hpy666666/xiaozhi-esp32-pet/docs/pet/照片添加指南.md

# 📸 照片添加指南

## 需要拍摄的照片

请将照片拍好后放到项目的 `docs/pet/` 目录中，并按以下命名：

### 1️⃣ 整体外观 (1张)
- **cover.jpg** - 项目封面，展示完整的宠物机器人
  - 建议角度：45度斜角，能看到屏幕和舵机
  - 建议背景：纯色或简洁背景
  - 建议光线：充足自然光

### 2️⃣ 硬件细节 (3张)
- **hardware-front.jpg** - 正面视角
  - 展示OLED屏幕、麦克风、扬声器位置

- **hardware-back.jpg** - 背面接线
  - 展示舵机连接、电源模块、PCB布局

- **pcb-detail.jpg** - PCB细节
  - 展示主控芯片、电源模块、接口等

### 3️⃣ 表情演示 (3张)
- **emotion-idle.jpg** - 待机状态
  - 屏幕显示慵懒眨眼动画

- **emotion-happy.jpg** - 开心表情
  - 屏幕显示开心表情（圆眼睛）

- **emotion-speaking.jpg** - 说话中
  - 屏幕显示说话表情（张嘴）

### 4️⃣ 动作演示 (3张)
- **action-stand.jpg** - 站立姿态
  - 4个舵机处于站立位置（90度）

- **action-sit.jpg** - 坐下
  - 前腿趴下，后腿站立

- **action-wave.jpg** - 挥手
  - 右前腿抬起摆动

---

## 📷 拍摄技巧

### 照片要求
- **分辨率**: 至少 1280×720 (720p)
- **格式**: JPG 或 PNG
- **大小**: 单张不超过 2MB（GitHub会自动压缩）
- **方向**: 横向拍摄（16:9 或 4:3）

### 光线建议
- ✅ 使用自然光或白色LED灯
- ✅ 避免强烈阴影
- ❌ 避免逆光（屏幕会看不清）
- ❌ 避免黄光（颜色失真）

### 背景建议
- ✅ 纯色背景（白色、浅灰、浅蓝）
- ✅ 简洁的桌面
- ❌ 杂乱的环境
- ❌ 太花哨的背景

### 拍摄角度
- **整体照**: 45度斜角，能看到正面和侧面
- **细节照**: 正面或侧面，焦点清晰
- **屏幕照**: 正对屏幕，略微俯拍，避免反光

---

## 📁 如何添加照片到项目

### 方法1：复制到项目目录（推荐）

1. 将拍好的照片重命名（按上面的命名规则）
2. 复制到项目目录：
   ```
   C:\Users\34376\Desktop\xiaozhi-esp32-1.9.2_2\xiaozhi-esp32-1.9.2_2\docs\pet\
   ```
3. 使用Git提交：
   ```bash
   cd "C:\Users\34376\Desktop\xiaozhi-esp32-1.9.2_2\xiaozhi-esp32-1.9.2_2"
   git add docs/pet/*.jpg
   git commit -m "docs: 添加项目展示图片"
   git push
   ```

### 方法2：通过GitHub网页上传

1. 访问：https://github.com/hpy666666/xiaozhi-esp32-pet/tree/main/docs
2. 点击 "Add file" → "Upload files"
3. 创建 `pet/` 文件夹并上传照片
4. 填写commit信息："docs: 添加项目展示图片"
5. 点击 "Commit changes"

---

## ✅ 上传完成后

README中的图片会自动显示：
- https://github.com/hpy666666/xiaozhi-esp32-pet#-项目展示

如果照片数量不够，可以先上传部分，其余的后续补充。

---

## 📝 可选照片

如果想让项目更丰富，还可以添加：

- **wiring-diagram.jpg** - 接线图示意
- **size-comparison.jpg** - 与参照物对比大小
- **assembly-process.jpg** - 组装过程照片
- **gif-animation.gif** - 眨眼动画的GIF截图
- **action-sequence.gif** - 动作序列GIF

---

**准备好照片后告诉我，我可以帮你优化README的展示效果！**
