hpy666666/xiaozhi-esp32-pet/docs/guides/IDLE_ANIMATION_IMPLEMENTATION_SUMMARY.md

# Idle 眨眼动画系统实施完成总结

## ✅ 已完成的工作

### 1. 核心文件创建

#### 新增文件（6个）：
- ✅ `main/display/blink_animator.h` - 眨眼动画播放器接口
- ✅ `main/display/blink_animator.c` - 眨眼动画播放器实现
- ✅ `main/display/idle_emotion_controller.h` - Idle 状态控制器接口
- ✅ `main/display/idle_emotion_controller.c` - Idle 状态控制器实现
- ✅ `IDLE_BITMAPS_DESIGN.md` - 位图设计文档
- ✅ `IDLE_ANIMATION_IMPLEMENTATION_SUMMARY.md` - 本文档

### 2. 修改文件

#### `main/display/emotion_bitmaps.h`
- 新增 9 个枚举（3个系列 × 3个状态）
- EMOTION_COUNT 更新为 17

#### `main/display/emotion_bitmaps.c`
- 新增 9 个位图数据条目
- ⚠️ 当前使用占位符（复用现有位图）
- 📝 TODO: 替换为真实设计的位图

#### `main/display/oled_display.h`
- 新增 `IdleEmotionController idle_controller_` 成员
- 新增 `StartIdleAnimation()` / `StopIdleAnimation()` 方法

#### `main/display/oled_display.cc`
- 构造函数中初始化 `idle_controller_`
- 析构函数中清理 `idle_controller_`
- 实现 `StartIdleAnimation()` 和 `StopIdleAnimation()`

#### `main/application.cc`
- 修改 `SetDeviceState()` 添加 idle 动画控制逻辑
- kDeviceStateIdle → 启动 idle 动画
- 其他状态 → 停止 idle 动画，显示静态表情

#### `main/CMakeLists.txt`
- 添加 `blink_animator.c`
- 添加 `idle_emotion_controller.c`

---

## 🎯 系统功能

### 功能概述

**Idle 状态下**：
1. 每 5 分钟自动循环切换表情：
   - 0-5分钟: Normal 表情
   - 5-10分钟: Sleepy 表情
   - 10-15分钟: Bored 表情
   - 15分钟后循环回 Normal

2. 每个表情有独立的眨眼频率：
   - Normal: 3-5秒随机眨一次
   - Sleepy: 4-6秒随机眨一次（更慵懒）
   - Bored: 5-7秒随机眨一次（最慢）

3. 眨眼动画：
   - 5帧序列：睁眼 → 半闭 → 闭眼 → 半闭 → 睁眼
   - 每帧 80ms，总时长 400ms

**非 Idle 状态**：
- 停止眨眼动画
- 显示对应的静态表情（基于 emotion_manager.c 的映射）

---

## 📊 技术架构

```
Application (application.cc)
    ↓
SetDeviceState(kDeviceStateIdle)
    ↓
OledDisplay::StartIdleAnimation()
    ↓
IdleEmotionController
    ├─ State Switch Timer (5分钟)
    │   └─ Normal → Sleepy → Bored → 循环
    ├─ Blink Timer (3-7秒随机)
    │   └─ 触发 BlinkAnimator
    └─ BlinkAnimator
        └─ Frame Timer (80ms)
            └─ 播放5帧眨眼序列
```

---

## ⚠️ 注意事项

### 1. 位图占位符

**当前状态**: 9 个新表情使用占位符数据（复用现有位图）

**位置**: `main/display/emotion_bitmaps.c` 行 613-680

```c
// 临时占位符示例
[EMOJI_IDLE_NORMAL_OPEN] = {
    .data = emoji_happy_data,  // ← 复用现有位图
    ...
},
```

**替换方法**:
1. 参考 `IDLE_BITMAPS_DESIGN.md` 中的参数
2. 使用绘图软件（Paint.NET, GIMP等）绘制 9 个 128x64 位图
3. 用 image2cpp 转换（https://javl.github.io/image2cpp/）
4. 替换占位符数据

### 2. 测试时可缩短时间

**位置**: `main/display/idle_emotion_controller.c` 行 13

```c
#define STATE_SWITCH_INTERVAL_MS (5 * 60 * 1000)  // 5 minutes
```

**测试建议**: 改为 30 秒便于快速验证
```c
#define STATE_SWITCH_INTERVAL_MS (30 * 1000)  // 30 seconds for testing
```

### 3. 线程安全

所有 LVGL 操作都通过 `DisplayLockGuard` 保护，无需担心多线程问题。

---

## 🚀 编译和测试步骤

### 步骤 1: 进入项目目录

```bash
cd C:\Users\34376\Desktop\xiaozhi-esp32-1.9.2_2\xiaozhi-esp32-1.9.2_2
```

### 步骤 2: 删除旧的编译文件

```bash
idf.py fullclean
```

### 步骤 3: 重新编译项目

```bash
idf.py build
```

### 步骤 4: 烧录到设备并监视串口

```bash
idf.py -p COM5 flash monitor
```
（根据实际串口号调整 COM5）

---

## 💾 内存占用分析

### Flash 存储占用

**位图数据**:
- 原有 8 个表情: 8 × 1024 = 8,192 字节 (8 KB)
- 新增 9 个表情: 9 × 1024 = 9,216 字节 (9 KB)
- **总计**: 17,408 字节 (**17 KB**)
- 📝 注意：当前占位符阶段实际新增很少，真实位图替换后才会占用 9 KB

**代码占用**:
- blink_animator.c: ~3 KB
- idle_emotion_controller.c: ~5 KB
- 其他修改: ~2 KB
- **总计**: ~10 KB

**Flash 总新增**:
- 占位符阶段: ~10 KB
- 真实位图替换后: ~20 KB

### RAM 运行时占用

- IdleEmotionController 结构体: < 200 字节
- BlinkAnimator 结构体: < 100 字节
- ESP 定时器 (3个): ~150 字节
- **总计**: < **500 字节**

### 结论

✅ ESP32-S3 拥有 **8MB PSRAM** 和 **16MB Flash**
✅ 本系统仅占用 **20 KB Flash** + **500 字节 RAM**
✅ **完全无需担心内存问题**

---

## 👀 测试验证

### 观察串口日志

关键日志信息：

```
I (xxx) OledDisplay: Idle emotion controller initialized
I (xxx) IdleController: Starting idle animation
I (xxx) IdleController: State 0 (Normal)
I (xxx) IdleController: Next blink in 3245 ms
I (xxx) BlinkAnimator: Starting blink animation (open=8, half=9, closed=10)
I (xxx) IdleController: Switched to state 1 (Sleepy)
I (xxx) IdleController: Switched to state 2 (Bored)
```

### 步骤 4: 验证功能

**预期行为**:

1. **进入 Idle 状态**:
   - 屏幕显示表情（当前为占位符位图）
   - 每 3-5 秒眨眼一次

2. **切换到其他状态（如 Listening）**:
   - 眨眼停止
   - 显示 Listening 对应的静态表情

3. **回到 Idle**:
   - 重新开始眨眼动画
   - 从 Normal 状态开始

4. **长时间待机（测试完整循环）**:
   - 0-5min: Normal 眨眼
   - 5-10min: Sleepy 眨眼（更慢）
   - 10-15min: Bored 眨眼（最慢）
   - 15min后: 循环回 Normal

---

## 🐛 可能的编译错误

### 错误 1: 找不到 idle_emotion_controller.h

**原因**: CMakeLists.txt 未更新

**解决**: 确认 CMakeLists.txt 包含：
```cmake
"display/blink_animator.c"
"display/idle_emotion_controller.c"
```

### 错误 2: 未定义的引用

**可能原因**: C/C++ 链接问题

**解决**: 检查 `extern "C"` 声明是否正确

### 错误 3: EMOTION_COUNT 不匹配

**原因**: emotion_bitmaps.h 中 EMOTION_COUNT 应为 17

**解决**: 确认枚举定义正确

---

## 📝 后续工作

### 必做（影响功能）:

1. **替换占位符位图**
   - 使用 IDLE_BITMAPS_DESIGN.md 中的参数
   - 绘制真实的眨眼序列位图
   - 优先级: ★★★★★

### 可选（优化体验）:

2. **调整眨眼频率**
   - 根据实际观感微调 3-7 秒的范围
   - 优先级: ★★★☆☆

3. **添加更多 Idle 表情**
   - 例如: Curious, Playful, Relaxed
   - 修改 `idle_emotion_controller.c` 添加到循环
   - 优先级: ★★☆☆☆

4. **实现动态眼球追踪**
   - 参考 dog 项目的 LookAssistant
   - 眼球可以在 idle 时看向不同方向
   - 优先级: ★★★★☆

---

## 📚 相关文件索引

| 文件 | 用途 | 关键函数 |
|---|---|---|
| `blink_animator.c` | 眨眼动画播放 | `blink_animator_play()` |
| `idle_emotion_controller.c` | Idle 状态管理 | `idle_controller_start/stop()` |
| `oled_display.cc` | 集成点 | `StartIdleAnimation()` |
| `application.cc` | 状态机触发 | `SetDeviceState()` |
| `emotion_bitmaps.c` | 位图数据 | 占位符位置 613-680 行 |
| `IDLE_BITMAPS_DESIGN.md` | 设计文档 | 位图绘制参数 |

---

## ✨ 成果

通过本次实施，你的小智宠物现在拥有：

✅ **生动的 Idle 状态** - 不再是死板的静态画面
✅ **自动眨眼** - 显得更"活着"
✅ **状态变化** - 5 分钟循环展现不同"心情"
✅ **智能切换** - Idle 和工作状态无缝过渡
✅ **可扩展架构** - 未来可轻松添加更多表情或动画

---

**实施日期**: 2025-11-08
**版本**: xiaozhi-esp32 v1.9.2+
**状态**: ✅ 代码完成，等待编译测试
