hpy666666/xiaozhi-esp32-pet/(list of files, drawings)

Other design files:
hardware/ProDoc_PCB2_2026-01-19.epro
hardware/ProDoc_Schematic1_2026-01-19.epro
