hpy666666/xiaozhi-esp32-pet/main/display/lazy_blink_gif.c

#ifdef __has_include
    #if __has_include("lvgl.h")
        #ifndef LV_LVGL_H_INCLUDE_SIMPLE
            #define LV_LVGL_H_INCLUDE_SIMPLE
        #endif
    #endif
#endif

#if defined(LV_LVGL_H_INCLUDE_SIMPLE)
    #include "lvgl.h"
#else
    #include "lvgl/lvgl.h"
#endif


#ifndef LV_ATTRIBUTE_MEM_ALIGN
#define LV_ATTRIBUTE_MEM_ALIGN
#endif

#ifndef LV_ATTRIBUTE_IMG_LAZY_BLINK_GIF
#define LV_ATTRIBUTE_IMG_LAZY_BLINK_GIF
#endif

const LV_ATTRIBUTE_MEM_ALIGN LV_ATTRIBUTE_LARGE_CONST LV_ATTRIBUTE_IMG_LAZY_BLINK_GIF uint8_t lazy_blink_gif_map[] = {
    0x47, 0x49, 0x46, 0x38, 0x39, 0x61, 0x80, 0x00, 0x40, 0x00, 0xf4, 0x0d, 0x00, 
    0x00, 0x00, 0x00, 0x01, 0x01, 0x01, 0x02, 0x02, 0x02, 0x03, 0x03, 0x03, 0x04, 
    0x04, 0x04, 0xfb, 0xfb, 0xfb, 0xfc, 0xfc, 0xfc, 0xfd, 0xfd, 0xfd, 0xff, 0xff, 
    0xff, 0x05, 0x05, 0x05, 0xfa, 0xfa, 0xfa, 0xf9, 0xf9, 0xf9, 0xf8, 0xf8, 0xf8, 
    0xf5, 0xf5, 0xf5, 0xf3, 0xf3, 0xf3, 0x06, 0x06, 0x06, 0x08, 0x08, 0x08, 0xf6, 
    0xf6, 0xf6, 0xf4, 0xf4, 0xf4, 0x09, 0x09, 0x09, 0x0b, 0x0b, 0x0b, 0xef, 0xef, 
    0xef, 0x0a, 0x0a, 0x0a, 0x0c, 0x0c, 0x0c, 0x0d, 0x0d, 0x0d, 0x10, 0x10, 0x10, 
    0xf2, 0xf2, 0xf2, 0x00, 0x00, 0x00, 0x00, 0x00, 0x00, 0x00, 0x00, 0x00, 0x00, 
    0x00, 0x00, 0x00, 0x00, 0x00, 0x21, 0xff, 0x0b, 0x4e, 0x45, 0x54, 0x53, 0x43, 
    0x41, 0x50, 0x45, 0x32, 0x2e, 0x30, 0x03, 0x01, 0x00, 0x00, 0x00, 0x21, 0xfe, 
    0x2e, 0x47, 0x49, 0x46, 0x20, 0x63, 0x6f, 0x6d, 0x70, 0x72, 0x65, 0x73, 0x73, 
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
    0xa2, 0x96, 0xa2, 0xda, 0x85, 0x63, 0x55, 0x96, 0x47, 0x2c, 0x74, 0xf5, 0x3a, 
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
};

const lv_image_dsc_t lazy_blink_gif = {
    .header = {
        .cf = LV_COLOR_FORMAT_RAW,
        .w = 128,
        .h = 64,
    },
    .data_size = 6873,
    .data = lazy_blink_gif_map,
};
