hpy666666/xiaozhi-esp32-pet/(commit log)

2025-11-09 feat: Initial commit - Xiaozhi ESP32 Pet Robot
    Features:
    - 4-servo control system for pet movements
    - Dynamic blinking GIF animation with LVGL v9
    - 18 static emotion bitmaps
    - Staggered servo startup to prevent brownout
    - Gaussian/Sine/Smootherstep blink curves
    - MT3608 power supply optimization
    - MCP protocol integration for voice-controlled actions
    Hardware:
    - ESP32-S3-N16R8
    - SH1106 OLED (128x64)
    - INMP441 microphone
    - MAX98357 audio amplifier
    - 4x SG90 servos
    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
    [16m.csv, 16m_c3.csv, 16m_custom_wakeword.csv, 16m_echoear.csv, 32m.csv, 4m.csv, 4m_esp-hi.csv, 8m.csv]
2025-11-09 docs: 更新README - 添加完整工具链和资源链接
    - 添加动画制作完整教程（Python→ezgif→LVGL）
    - 添加所有在线工具链接
    - 添加开发文档资源
    - 完善硬件需求和引脚定义
    - 添加常见问题FAQ
    - 优化文档结构和排版
2025-11-09 docs: 添加项目实拍照片和更新展示区
    - 添加3张项目实拍照片（正脸、左侧、右侧）
    - 更新README展示区使用实际照片
    - 致谢部分添加嘉立创免费打板
    - 优化图片展示布局
2025-11-09 fix: 修正更新日志中的日期错误 (2025-01-09 → 2025-11-09)
2026-01-19 重构项目结构，专注xiaozhi-pet版本
    - 精简boards配置，只保留xiaozhi-pet和common
    - 移动92个其他板子配置到docs/other-boards/
    - 整理所有文档到docs/文件夹
    - 更新hardware/为最新设计文件（嘉立创EDA格式）
    - 添加Fork说明和上游项目追踪（UPSTREAM.md）
    - 优化README，明确项目定位
    [ProDoc_PCB2_2026-01-19.epro, ProDoc_Schematic1_2026-01-19.epro]
2026-01-19 清理根目录，移除多余配置文件
    - 删除不需要的芯片配置文件（esp32/c3/c6/p4）
    - 删除临时构建文件（sdkconfig, sdkconfig.old）
    - 移动IDE配置到docs/dev-tools/
    - 更新.gitignore防止这些文件再次被提交
2026-01-19 更新日志，添加v1.9.3版本说明
    添加2026-01-19项目结构重构记录
2026-01-19 改进硬件图片展示方式
    将原理图和PCB图片改为直接展示，提升可读性
