hpy666666/xiaozhi-esp32-pet/(notices)

Notices in the files:
README.md:
License: MIT
